vincentperot/ecgmonitor/android/eegmonitor-web.png

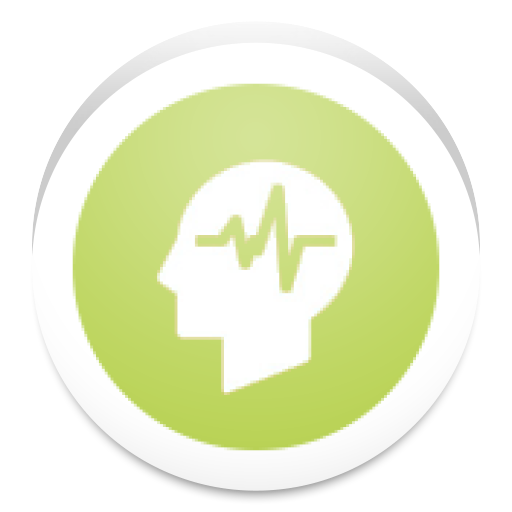
android/eegmonitor-web.png
